djklup/SignalSenders/Project Details/IMG_0490.JPG

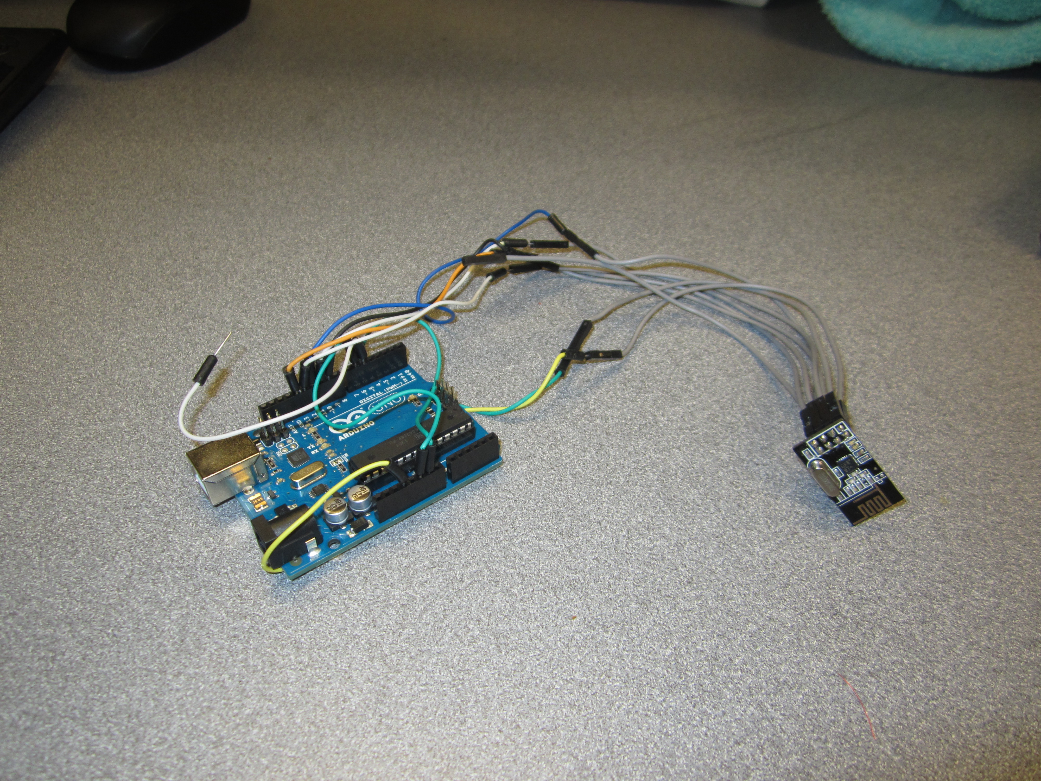
Project Details/IMG_0490.JPG
