djklup/SignalSenders/Project Details/IR Presentation 3.pptx

## Infrared alert system with radio frequency capability

T09-Signal senderS
Max Cope
Leslie Eide
Chris Klupenger

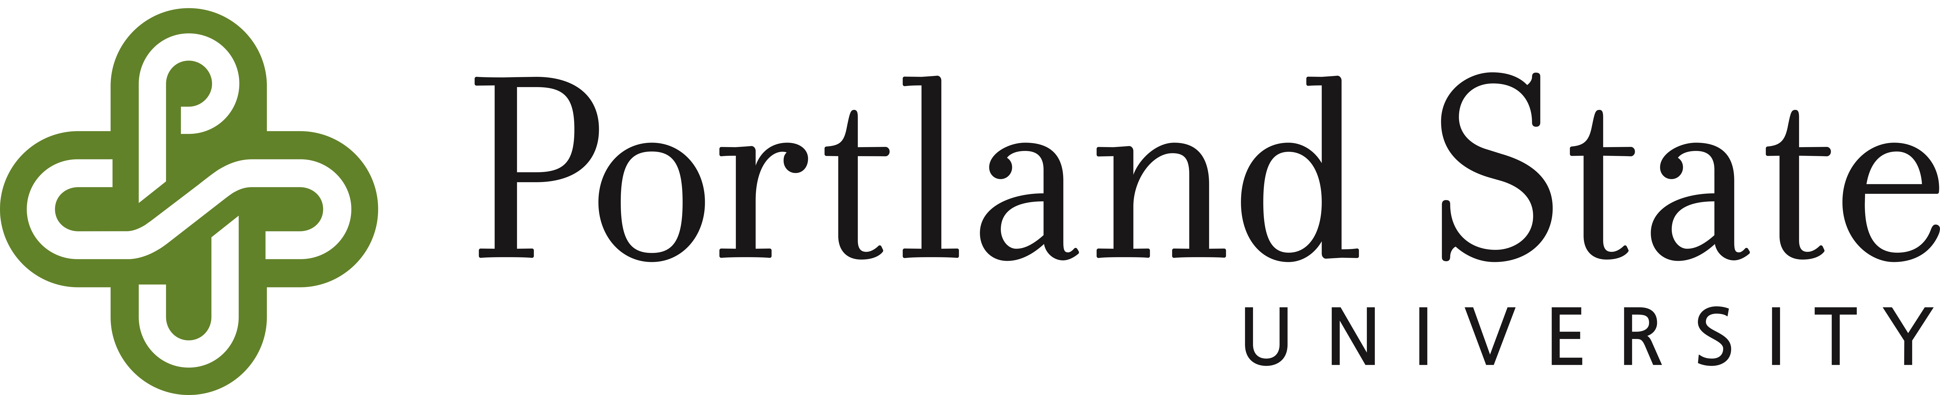
[picture p2: figure]
PSU_white_screen

SignalSenders

## Problem

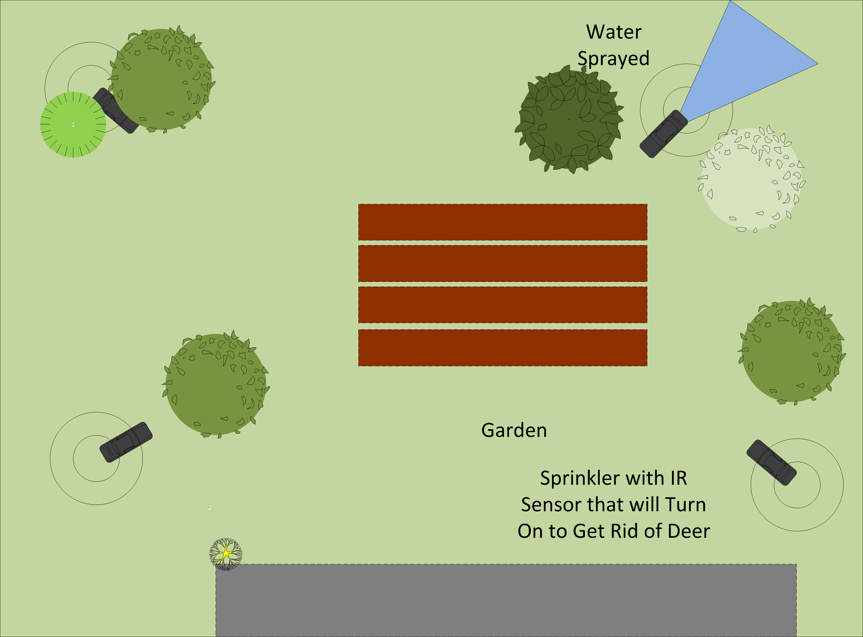
[picture p3: figure]

- Practicum Project Guidelines

Motivation

- Originated from Sprinklers Systems Designed to Keep Deer off Property
- The Systems Lacked Many Features
  - Communication Between Units
  - Timers

SignalSenders

## Objective

- Develop a Security Network with Communication Capabilities
- Utilize Communication within the 2.4GHz ISM band to lessen complexity
- Battery Operated to Eliminate Hard Wired Constrictions

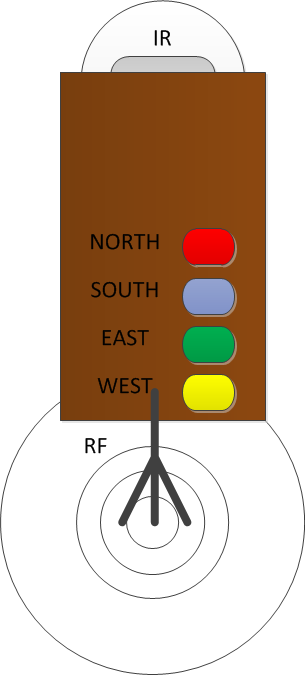
[picture p4: figure]

SignalSenders

## Alternatives

- Wired UNITS

- Inefficient at larger ranges
- Cables everywhere

- Signal Options

- WIFI
- Bluetooth
- RF Signals
- IR Signal

SignalSenders

## Requirements

- Motion Sensor

- Used to sense motion within a specified range
- Signal used to send specified signal to microcontroller for further processing

- microcontroller

- Central to the operation of this system
- Takes signal from IR and tells the RF module to send a signal that it detected motion
- Takes signal from RF module that another unit sensed motion and light up the corresponding LED associated with the unit ID

- Signal

- In standby listening for a signal from the other units to send to the microcontroller
- When prompted from the Microcontroller a signal with unit ID is transmitted to the other units

SignalSenders

## Approach

Change to something other than interrupt.

Interaction View

Activity View

Change to 1 pin

Change to 5 pin spi

SignalSenders

## Design

Identifying the Appropriate
  - Motion Detector
  - Microcontroller
  - RF Transceiver
  - LED Indicators
  - Battery Power
  - Housing

SignalSenders

## Infrared motion sensor Design

- 5v Power
- Ground
- 1 Bit Active High Data Bit
- User Definable Potentiometers
  - Sensitivity
  - Rate of (detection?)

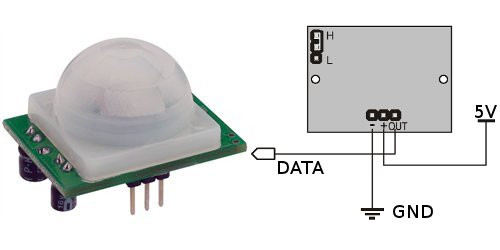
[picture p5: figure]

SignalSenders

## Radio frequency Communication

- Handles All RF Tasks
- 2.4 GHz ISM Band
  - Worldwide license-free
- Communication Pipes
  - A Unique Pipe for Each Units Communication
  - Simultaneous Unit Communication

- SPI interfacing with C
  - CE
  - CS
  - MOSI
  - MISO
  - SCK
- Configurable through Programming
- “RF24” Libraries.

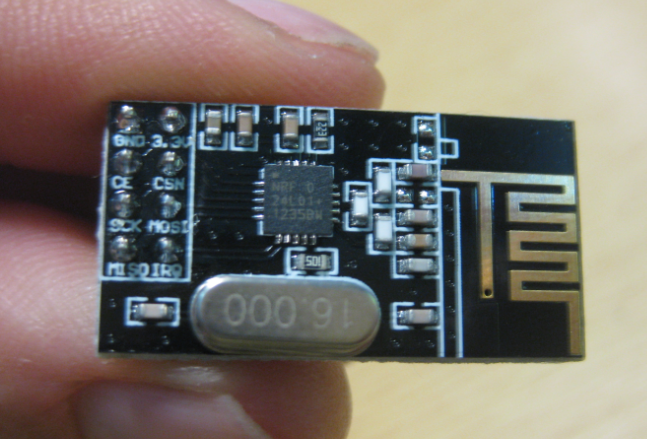
[picture p6: figure]

SignalSenders

## Microcontroller Programming

- ATMEGA 328P
- Programming
  - IR Detect
  - RF SPI
  - Four LED
  - Unit Identification

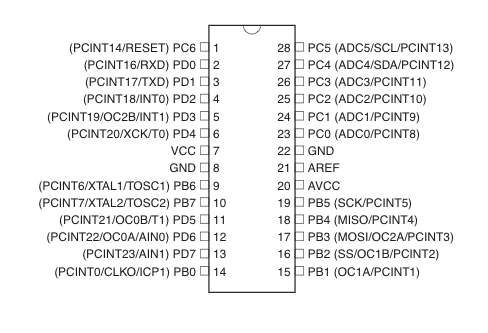
[picture p7: figure]

- Programmed Through SPI

SignalSenders

## LED Output

- Four LED Outputs
  - One LED Indicator to Represent Each Unit
  - All Power Sourced from C!
- Analog Voltage Signal
- Blink to Indicate a Trip on Respective Unit.
  - Specified Indication Time Span

SignalSenders

## Slide 12

Verification

- Subsections of circuit were built and tested on breadboard
- Changes such as digital output pins used, SPI connectivity, etc. stemmed from early verification work

## Implementation Schematic - POWER

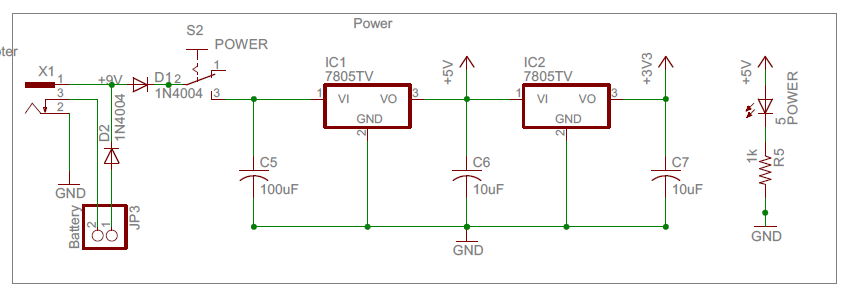
[picture p8: figure]

SignalSenders

## Implementation Schematic – Modules

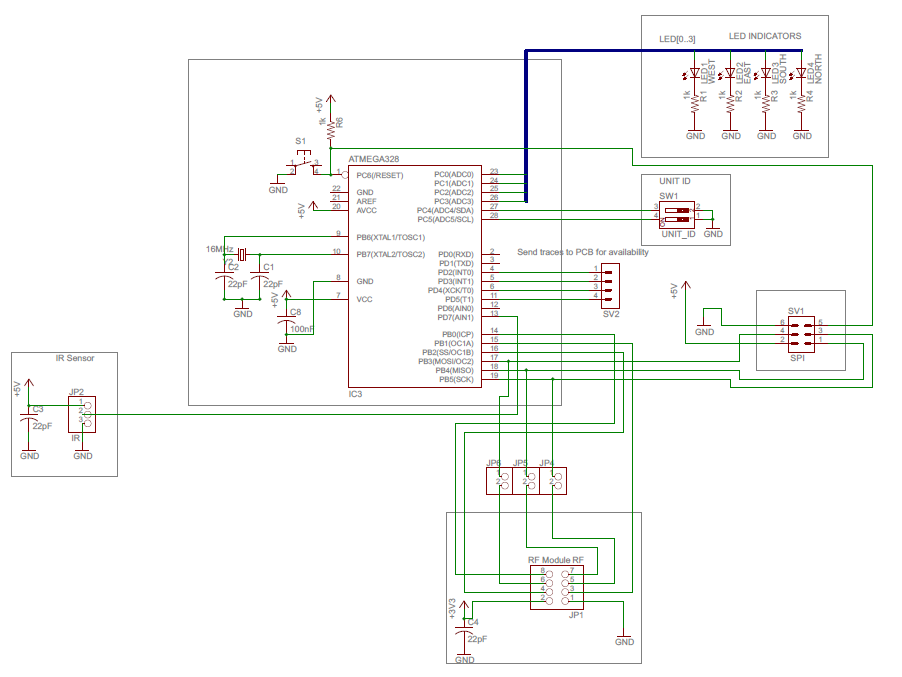
[picture p9: figure]

SignalSenders

## Implementation PCB

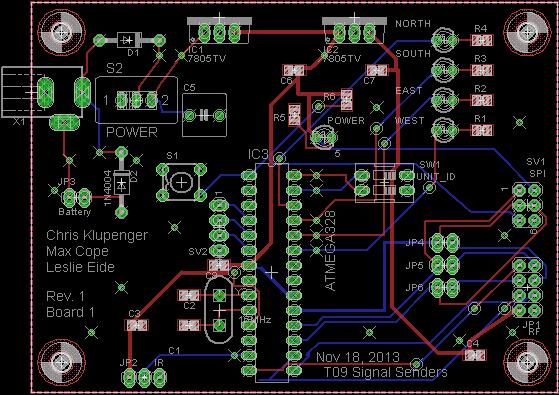
[picture p10: figure]

SignalSenders

## Intellectual property prior work

- RF Module libraries found online
- Open source Arduino coding
- Nothing proprietary created
- No schematics followed

SignalSenders

## Testing

- Strategy

- Testing power
- Continuity
- Layering complexity

- Execution

- Talk about issues/lack there of

SignalSenders

## Results

- 4 working units (video potential?)

SignalSenders

## Contributions

- Max cope

- RF signals
- RF Firmware

- Leslie Eide

- IR motion detector
- LED output panel

- Microcontroller
- Programming

- Chris Klupenger

SignalSenders

## Lessons Learned

SignalSenders
