djklup/SignalSenders/Project Details/IR Presentation 2.pptx

## Infrared alert system with radio frequency capability

T09-Signal senderS
Max Cope
Leslie Eide
Chris Klupenger

PSU_white_screen

SignalSenders

## Problem


- Practicum Project Guidlines

Motivation

- Originally got idea from sprinklers designed to keep deer out of yards.
- Interests in Radio signals
- Battery operation for range extension
- Original concepts included mechanical aspects for actuation

SignalSenders

## Objective

- Develop four working prototypes that can communicate with each other when they sense motion.
- Utilize communication within the 2.4GHz ISM band to lessen complexity
- Rely on battery power to reduce bulk and understand current dissipation vs voltage


SignalSenders

## Alternatives

- Wired

- Inefficient at larger ranges

- Wi-fi

- Bluetooth was also explored

SignalSenders

## Requirements

- Motion Sensor

- Used to sense motion within a specified range
- Signal used to send specified signal to microcontroller for further processing

- microcontroller

- Central to the operation of this system
- Takes signal from IR and tells the RF module to send a signal that it detected motion
- Takes signal from RF module that another unit sensed motion and light up the corresponding LED associated with the unit ID

- Signal

- In standby listening for a signal from the other units to send to the microcontroller
- When prompted from the Microcontroller a signal with unit ID is transmitted to the other units

SignalSenders

## Approach

SignalSenders

## Design

- Selection of motion detection
- Selection of Microcontroller
- Selection of communication
- Selection of Actuator
- Selection of battery power
- Design of schematic
- Design of PCB
- Housing

SignalSenders

## Infrared motion sensor Design

- Range
- Output of Signal


SignalSenders

## Radio frequency Communication

- 2.4 GHz ISM Band
  - Worldwide license-free
- GFSK modulation
- Communication Pipes
- SPI interfacing with uC


SignalSenders

## Microcontroller Programming

- ATMEGA 328P
- Programming
  - IR Detect
  - RF SPI
  - Four LED


SignalSenders

## LED Output

- Layout of board/housing

SignalSenders

## Schematic/PCB


## Implementation

SignalSenders

## Intellectual property prior work

- No idea about this slide waiting for Monday

SignalSenders

## Testing

- Strategy

- Execution

SignalSenders

## Results

- 4 working units (video potential?)

SignalSenders

## Contributions

- Max cope

- RF signals
- RF Firmware

- Leslie Eide

- IR motion detector
- LED output panel

- Microcontroller
- Programming

- Chris Klupenger

SignalSenders

## Lessons Learned

SignalSenders
