djklup/SignalSenders/Project Details/IR Presentation.pptx

## Infrared alert system with radio frequency capability

Signal senders
Max Cope
Leslie Eide
Chris Klupenger

PSU_white_screen

SignalSenders

## Problem

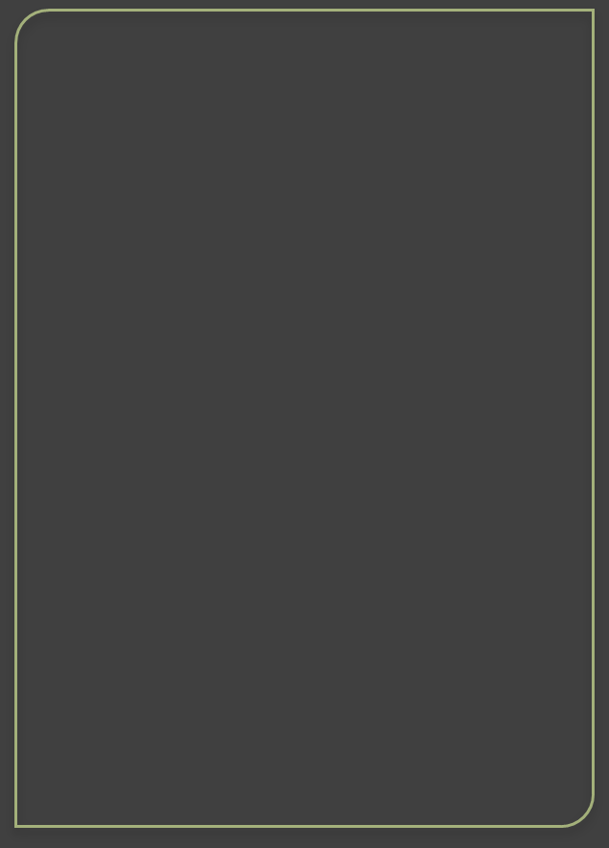
[picture p11: figure]

- Utilize our skills to build a project from the ground up

Motivation

- Interests in Radio signals
- Battery operation for range extension
- Original concepts included mechanical aspects for actuation

SignalSenders

## Objective

- Develop a working prototype with four units that can communicate to each other when they sense motion.
- Utilize wireless signals within (Hz range) adhering to FCC regulations
- Rely on battery power to reduce bulk and understand the current dissipation vs voltage

SignalSenders

## Alternatives

- Wired

- Difficult to implement in large range spans

- Wi-fi

- Bluetooth was also explored

SignalSenders

## Requirements

- Motion Sensor

- Used to sense motion within a specified range
- Signal used to send specified signal to microcontroller for further processing

- microcontroller

- Central to the operation of this system
- Takes signal from IR and tells the RF module to send a signal that it detected motion
- Takes signal from RF module that another unit sensed motion and light up the corresponding LED associated with the unit ID

- Signal

- In standby listening for a signal from the other units to send to the microcontroller
- When prompted from the Microcontroller a signal with unit ID is transmitted to the other units

SignalSenders

## Approach

SignalSenders

## Design

- Selection of motion detection
- Selection of Microcontroller
- Selection of communication
- Selection of Actuator
- Selection of battery power
- Design of schematic
- Design of PCB
- Housing

SignalSenders

## Infrared motion sensor Design

- Range
- Output of Signal

SignalSenders

## Radio frequency Communication

- Communication to send
- Communication to recieve

SignalSenders

## Microcontroller Programming

- Choice of Microcontroller
- Programming
- Interface??

SignalSenders

## LED Output

- Layout of board/housing

SignalSenders

## Schematic/PCB

## Implementation

SignalSenders

## Intellectual property prior work

- No idea about this slide waiting for Monday

SignalSenders

## Testing

- Strategy

- Execution

SignalSenders

## Results

- 4 working units (video potential?)

SignalSenders

## Contributions

- Max cope

- RF signals

- Leslie Eide

- IR motion detector
- LED output panel

- Microcontroller
- Programming

- Chris Klupenger

SignalSenders

## Lessons Learned

SignalSenders
