djklup/SignalSenders/Board/T09_Board Layout.pdf

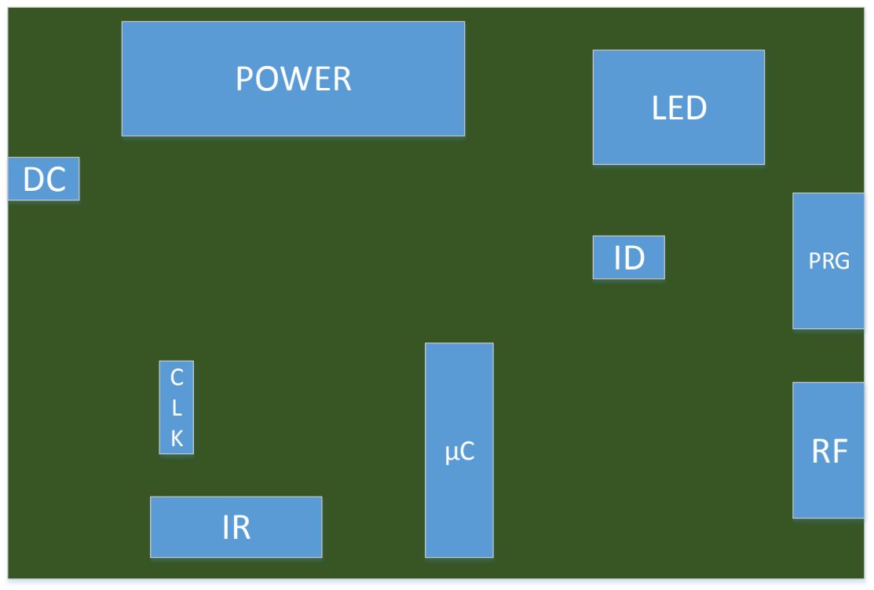
[picture p12: page 1]

POWER

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
