djklup/SignalSenders/Project Details/Gnatt Chart.pdf

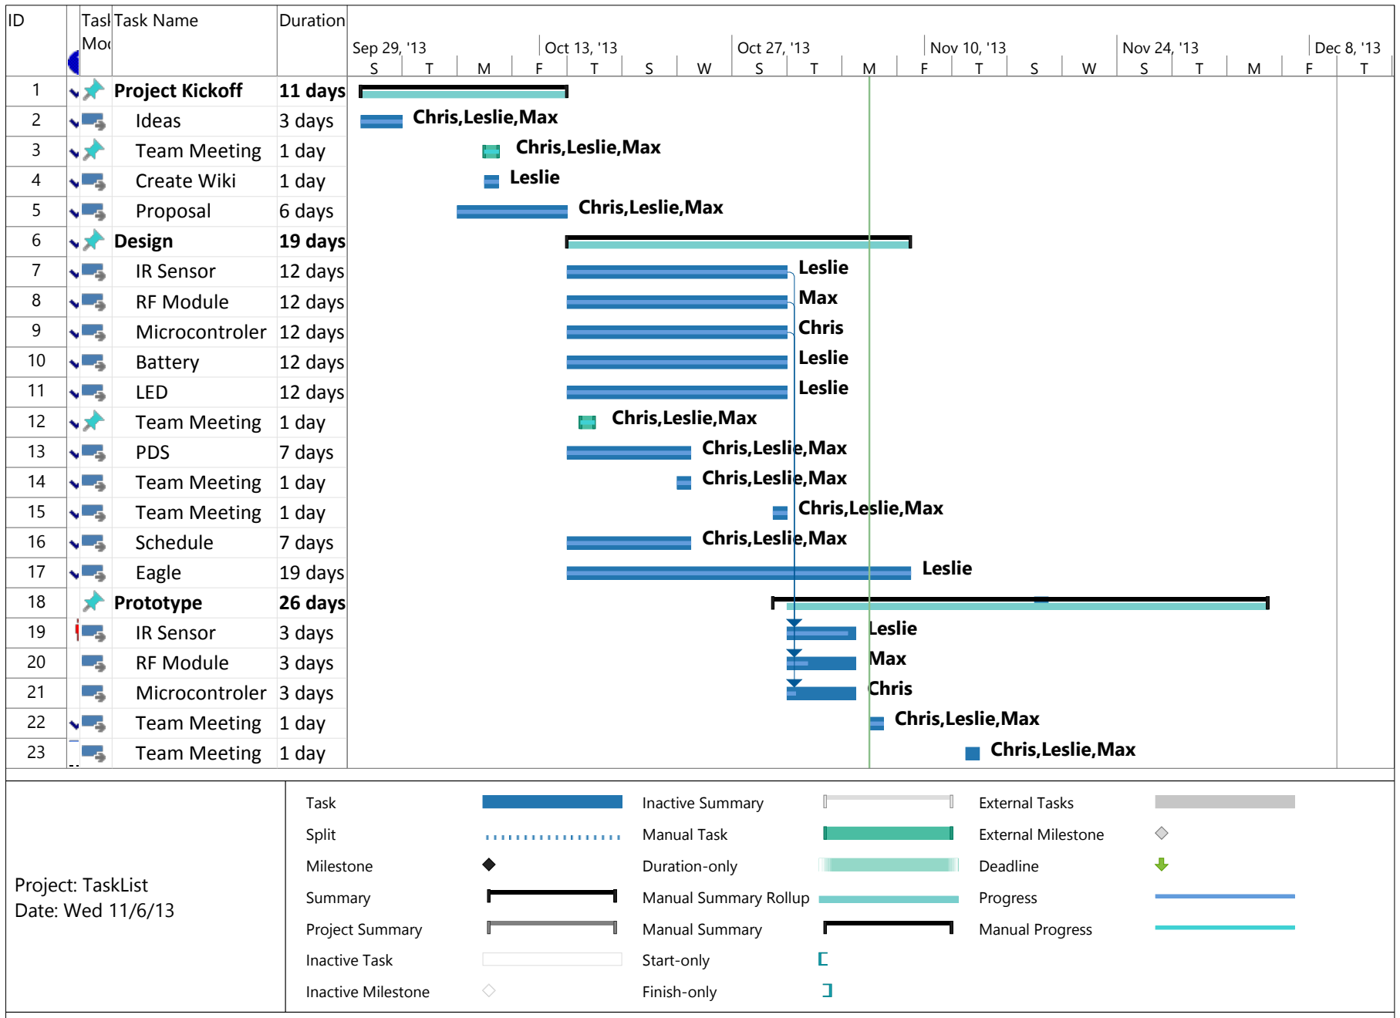
[picture p13: figure]
Task; Mode; Task Name; Duration; Project Kickoff; 11 days; Ideas; 3 days; Team Meeting; 1 day; Create Wiki; Proposal; 6 days; Design; 19 days; IR Sensor; 12 days; RF Module; Microcontroler; Battery; LED; PDS; 7 days; Schedule; Eagle; Prototype; 26 days; Chris,Leslie,Max; Leslie; Max; Chris; Sep 29, '13; Oct 13, '13; Oct 27, '13; Nov 10, '13; Nov 24, '13; Dec 8, '13; Split; Milestone; Summary; Project Summary; Inactive Task; Inactive Milestone; Inactive Summary; Manual Task; Duration-only; Manual Summary Rollup; Manual Summary; Start-only; Finish-only; External Tasks; External Milestone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

ID | Task
Mode
| Task Name | Duration
24 | System Design | 6 days
25 | Team Meeting | 1 day
26 | Order Parts | 11 days
27 | Order Board | 1 day
28 | Test Plan | 6 days
29 | GetHub | 1 day
30 | Team Meeting | 1 day
31 | Construction | 4 days
32 | Team Meeting | 1 day
33 | Construction | 1 day
34 | Housing | 1 day
35 | Testing | 4 days
36 | Presentation | 11 days
37 | Power Point | 11 days
38 | Demostration | 1 day
39 | Final Review | 1 day

Chris,Leslie,Max
Chris,Leslie,Max
Chris,Leslie,Max
Chris,Leslie,Max
Chris,Leslie,Max
Chris
Chris,Leslie,Max

Chris,Leslie,Max
Chris,Leslie,Max
Chris,Leslie,Max
Chris,Leslie,Max

Chris,Leslie,Max
Chris,Leslie,Max
Chris,Leslie,Max
S | T | M | F | T | S | W | S | T | M | F | T | S | W | S | T | M | F | T
Sep 29, '13 | Oct 13, '13 | Oct 27, '13 | Nov 10, '13 | Nov 24, '13 | Dec 8, '13

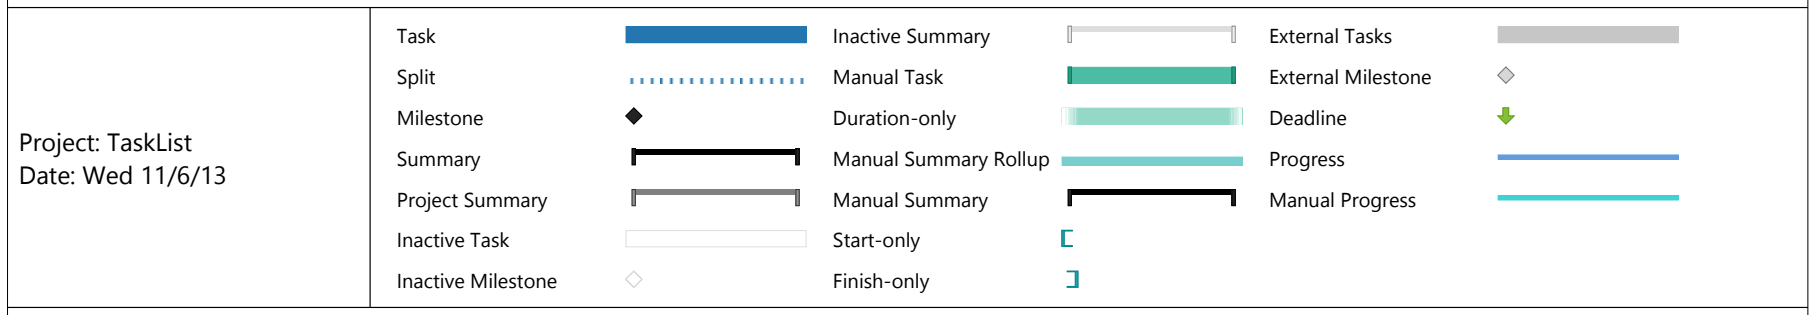
[picture p14: figure]
Task; Split; Milestone; Summary; Project Summary; Inactive Task; Inactive Milestone; Inactive Summary; Manual Task; Duration-only; Manual Summary Rollup; Manual Summary; Start-only; Finish-only; External Tasks; External Milestone; Deadline; Progress; Manual Progress; Project: TaskList Date: Wed 11/6/13
