djklup/SignalSenders/Project Details/BOM.xlsx

PART # | ITEM | PART # | DISTRIBUTOR | DIST PART # | Quantity | UNIT COST | TOTAL | SMT | PCB Verified
C1-C4 | 22pF CAPACITOR | C0805C220J5GACTU | DIGIKEY | 399-1113-1-ND | 30 | 0.048 | 1.44 | YES | YES
C5 | 100uF CAPACITOR | EEU-FR1C101B | DIGIKEY | P15330CT-ND | 10 | 0.409 | 4.09 | NO | YES
C6-C7 | 10uF CAPACITOR | C0805C106Z8VACTU | DIGIKEY | 399-8015-1-ND | 15 | 0.11 | 1.65 | YES | YES
C8 | 100nF CAPACITOR | CL21F104ZAANNNC | DIGIKEY | 1276-1286-1-ND | 10 | 0.031 | 0.31 | YES | YES
D1 | DIODE | 1N4004-T (http://www.digikey.com/product-detail/en/1N4004-T/1N4004DICT-ND/160593) | DIGIKEY | 1N4004DICT-ND | 10 | 0.12 | 1.20 | NO | YES
IC1 | VOLTAGE REG 5V | L78S05CV | DIGIKEY | 497-1468-5-ND | 10 | 0.637 | 6.37 | NO | YES
IC2 | VOLTAGE REG 3.3V | MCP1825S-3302E/AB | DIGIKEY | MCP1825S-3302E/AB-ND | 10 | 0.82 | 8.20 | NO | YES
IC3 | MICROCONTROLLER | ATMEGA328P-PU | DIGIKEY | ATMEGA328P-PU-ND | 10 | 3.16 | 31.60 | NO | YES
JP1 | PIN HEADER 2X4 FML | PPPC042LFBN-RC | DIGIKEY | S7107-ND | 10 | 0.699 | 6.99 | NO | YES
JP2-JP6 | 1x PIN HEADERS |  | HAVE |  |  |  | 0.00 | NO | YES
LED 1-5 | LEDs | LS-00016 | FRYS | 7726888 | 1 | 7.49 | 7.49 | NO | NO-SHOULD BE OK
R1-R6 | 1K RESISTOR | ERJ-P06J102V | DIGIKEY | P1.0KADCT-ND | 50 | 0.087 | 4.35 | YES | YES
S1 | PUSH BUTTON SWITCH | FSM4JH | DIGIKEY | 450-1650-ND | 10 | 0.092 | 0.92 | NO | YES
S2 | SLIDE POWER SWITCH |  | POWER |  |  |  | 0.00 | NO
SV1 | PIN HEADER 2X3 ML | 5-146254-3 | DIGIKEY | A105155-ND | 10 | 0.44 | 4.40 | NO | YES
SV2 | 1x PIN HEADERS |  | HAVE |  |  |  | 0.00 | NO | YES
SW1 | DIP SWITCH | 209-2MS | DIGIKEY | CT2092MS-ND | 10 | 0.543 | 5.43 | NO | YES
X1 | DC ADAPTER | PJ-202A | DIGIKEY | CP-202A-ND | 10 | 0.644 | 6.44 | NO | YES
Y2 | 16MHz CRYSTAL | ATS16B | DIGIKEY | CTX1085-ND | 10 | 0.3 | 3.00 | NO | YES
JMP1 | SHUNT/JUMPER | 4-881545-2 | DIGIKEY | A26853-ND | 25 | 0.257 | 6.42 | NO | YES
SKT 1 | uC IC SOCKET 28 POS | 1-390261-9 | DIGIKEY | A100210-ND | 10 | 0.411 | 4.11 | NO | YES
TOTAL |  |  |  |  |  |  | 104.42
RF 1 | RF Module 10 Pack | NRF24L01+ | EBAY |  | 1 | 17.28 |  | no | yes
IR 1 | IR SENSOR |  |  |  | 1
PCB | PCB BOARDS |  |  |  | 10
HS1 | HOUSING
