djklup/SignalSenders/(list of files, cad)

Other CAD files:
Parts/RF Module/code/51_NRF24L01+/test code/recive/recive.OBJ
Parts/RF Module/code/51_NRF24L01+/test code/send/send.OBJ
