djklup/SignalSenders/Project Details/TestingPlan.xlsx

Sheet: 5.1.1
Test Writer: Chris Klupenger
Test Case Name: |  | Power Switch and Indicator |  |  |  | Test ID #: | 5.1.1
Description: |  | Checks to make sure that power is initially being supplied to the unit. |  |  |  | Type: | White Box
Tester Information
Name of Tester: |  |  |  |  |  | Date
Hardware Ver: |  |  |  |  |  | Time
Setup: |  | Board Should be completely assembled with Power Supply connected
Step | Action | Expected Results | Pass | Fail | N/A | Comments
1 | Connect Power Supply and verify voltage at power supply | A measured Voltage of 8.9-9.1V
2 | Flip Switch on Power section of board | Verify that Power LED illumination lights up/turns off with flipping the switch
Overall test result:

Sheet: 5.1.2
Test Writer: Chris Klupenger
Test Case Name: |  | Power Supply Voltage |  |  |  | Test ID #: | 5.1.2
Description: |  | Checks to make sure that Power is being supplied to the board at the correct voltages. All measured voltages must be +- 5% of desired voltage to pass test. A multimeter will be used to measure voltage. |  |  |  | Type: | White Box
Tester Information
Name of Tester: |  |  |  |  |  | Date
Hardware Ver: |  |  |  |  |  | Time
Setup: |  | Power section on PCB should be set up with power supply attached and switch on
Step | Action | Expected Results | Pass | Fail | N/A | Comments
1 | Measure voltage out of +5V regulator | A measured voltage of 4.75-5.25V
2 | Measure voltage out of +3.3V regulator | A measured voltage of 3.14-3.47V
3 | Measure voltage on microcontroller | A measured voltage of 4.75-5.25V
Overall test result:

Sheet: 5.2.1
Test Writer: Leslie Eide
Test Case Name: |  | Power to IR Unit |  |  |  | Test ID #: | 5.2.1
Description: |  | The purpose of this test is to make sure that the IR Module is getting +5V. |  |  |  | Type: | White Box
Tester Information
Name of Tester: |  |  |  |  |  | Date
Hardware Ver: |  |  |  |  |  | Time
Setup: |  | Board is fully powered on and IR unit is installed on the unit
Step | Action | Expected Results | Pass | Fail | N/A | Comments
1 | Before connecting unit, verify voltage at connection | A measured Voltage of 4.9-5.1V
2 | Connect IR Unit | Connect multimeter to make sure that the unit is getting power
Overall test result:

Sheet: 5.2.2
Test Writer: Leslie Eide
Test Case Name: |  | Output Power and Duration |  |  |  | Test ID #: | 5.2.2
Description: |  | The purpose of this test is to record the output voltage and the duration of the signal. |  |  |  | Type: | White Box
Tester Information
Name of Tester: |  |  |  |  |  | Date
Hardware Ver: |  |  |  |  |  | Time
Setup: |  | Board is fully powered on and IR unit is installed on the unit
Step | Action | Expected Results | Pass | Fail | N/A | Comments
1 | Trip IR sensor | Output Voltage of 3.2-3.4 V
2 | Output Signal | Time Duration of signal for 10 seconds
Overall test result:

Sheet: 5.3.1
Test Writer:Max Cope
Test Case Name: |  | Power to RF Unit |  |  |  | Test ID #: | 5.3.1
Description: |  | The purpose of this test is to make sure that the RF Module is getting +3.3V +- 10%. |  |  |  | Type: | White Box
Tester Information
Name of Tester: |  |  |  |  |  | Date
Hardware Ver: |  |  |  |  |  | Time
Setup: |  | Board is fully powered on and RF unit is installed on the unit
Step | Action | Expected Results | Pass | Fail | N/A | Comments
1 | Before connecting unit, verify voltage at connection | A measured Voltage of 3-3.6V
2 | Connect RF Unit | Connect multimeter to make sure that the unit is getting power
Overall test result:

Sheet: 5.3.2
Test Writer:Max Cope
Test Case Name: |  | Transceiver Capability |  |  |  | Test ID #: | 5.3.2
Description: |  | Test module’s ability to both send and receive messages with no interference. |  |  |  | Type: | White Box
Tester Information
Name of Tester: |  |  |  |  |  | Date
Hardware Ver: |  |  |  |  |  | Time
Setup: |  | Two Arduino Unos are set up with RF test software loaded
Step | Action | Expected Results | Pass | Fail | N/A | Comments
1 | Connect module one to Arduino two | Module receives power and is on.
2 | Start Arduino tester software on Arduino one | Serial Port "Ready" message displayed on screen.
3 | Connect module two to Arduino two | Module receives power and is on.
4 | Start Arduino tester software on Arduino two | Serial port "Ready" message displayed on screen.
5 | Start test | Serial port should show a read out of the units "pinging" eachother and displaying timing results.
Overall test result:

Sheet: 5.4.1
Test Writer: Chris Klupenger
Test Case Name: |  | Microcontroller was Programmed |  |  |  | Test ID #: | 5.4.1
Description: |  | Test to verify that the microcontroller has the correct firmware running on it. |  |  |  | Type: | White Box
Tester Information
Name of Tester: |  |  |  |  |  | Date
Hardware Ver: |  |  |  |  |  | Time
Setup: |  | Unit should be fully assembled and powered on
Step | Action | Expected Results | Pass | Fail | N/A | Comments
1 | Trip the IR sensor | Verify that this units LED light is illuminated when the IR sensor is tripped
Overall test result:

Sheet: 5.5.1
Test Writer: Chris Klupenger
Test Case Name: |  | Testing Two Units |  |  |  | Test ID #: | 5.5.1
Description: |  | Verify that two units are communicating in an appropriate manner under various conditions. |  |  |  | Type: | Black Box
Tester Information
Name of Tester: |  |  |  |  |  | Date
Hardware Ver: |  |  |  |  |  | Time
Setup: |  | Two powered-on units should be placed on on opposite ends of a room from each other - maximum 100ft away
Step | Action | Expected Results | Pass | Fail | N/A | Comments
1 | North Unit Sends a Signal | South Unit Receives North Unit Signal
2 | South Unit Sends a Signal | North Unit Receives South Unit Signal
3 | Both Units Sends Signals | Both associated LED's Light up
4 | Wait 60 seconds | All LED's off
5 | Neither Sends a signal | No LED's Light up
6 | Wait 60 seconds | All LED's off
Overall test result:

Sheet: 5.5.2
Test Writer: Chris Klupenger
Test Case Name: |  | Testing Three Units |  |  |  | Test ID #: | 5.5.2
Description: |  | Verify that three units are communicating in an appropriate manner under various conditions. |  |  |  | Type: | Black Box
Tester Information
Name of Tester: |  |  |  |  |  | Date
Hardware Ver: |  |  |  |  |  | Time
Setup: |  | Three powered-on units should be placed on on opposite ends of a room from each other - maximum 100ft away from the farthest module. Each unit should be given a unique ID via the DIP switch.
Step | Action | Expected Results | Pass | Fail | N/A | Comments
1 | North Unit Sends a Signal | South and West Unit Recieves North Unit Signal
2 | South Unit Sends a Signal | North and West Unit Recieves South Unit Signal
3 | West Unit Sends a Signal | North and South Unit Recieves South Unit Signal
4 | All Units Sends Signals | All associated LED's Light up
5 | Wait 60 seconds | All LED's off
6 | Neither Sends a signal | No LED's Light up
7 | Wait 60 seconds | All LED's off
Overall test result:

Sheet: 5.5.3
Test Writer: Chris Klupenger
Test Case Name: |  | Testing Four Units |  |  |  | Test ID #: | 5.5.3
Description: |  | Verify that four units are communicating in an appropriate manner under various conditions. |  |  |  | Type: | Black Box
Tester Information
Name of Tester: |  |  |  |  |  | Date
Hardware Ver: |  |  |  |  |  | Time
Setup: |  | Three powered-on units should be placed on opposite ends of a room from each other - maximum 100ft away from the farthest module. Each unit should be given a unique ID via the DIP switch.
Step | Action | Expected Results | Pass | Fail | N/A | Comments
1 | North Unit Sends a Signal | South and West and East Unit Receives North Unit Signal
2 | South Unit Sends a Signal | North and West and East Unit Receives South Unit Signal
3 | West Unit Sends a Signal | North and South and East Unit Receives South Unit Signal
4 | East Unit Sends a Signal | North and South and West Unit Receives South Unit Signal
4 | All Units Sends Signals | All associated LED's Light up
5 | Wait 60 seconds | All LED's off
6 | Neither Sends a signal | No LED's Light up
7 | Wait 60 seconds | All LED's off
Overall test result:
