djklup/SignalSenders/Schematics/T09_Signal Senders.pdf

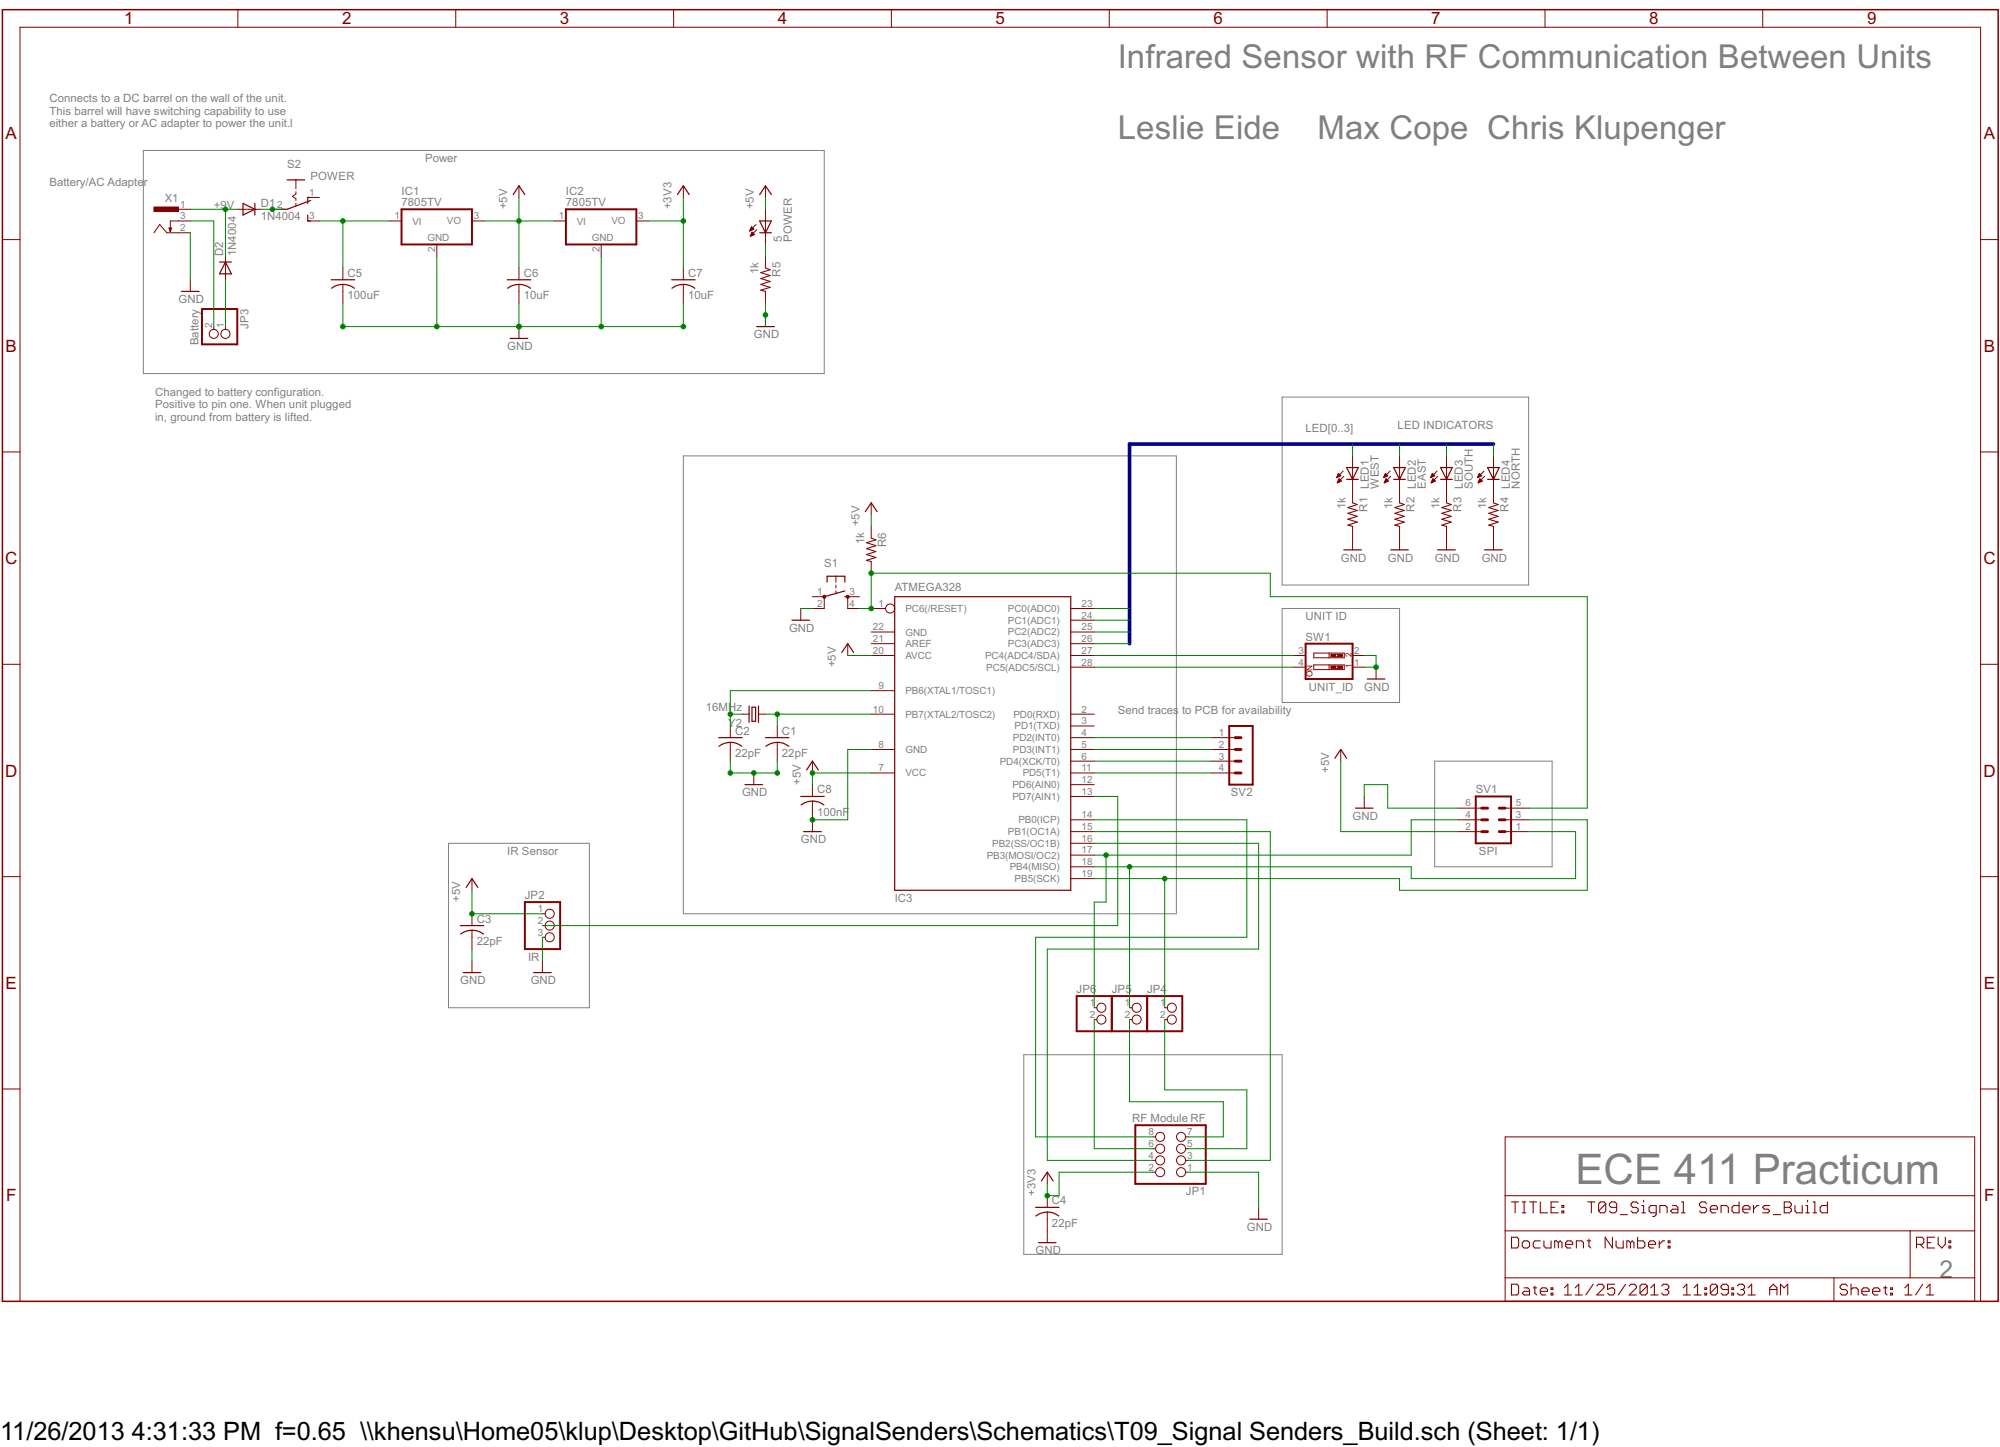
[picture p21: page 1]

Infrared Sensor with RF Communication Between Units

Connects to a DC barrel on the wall of the unit. This barrel will have switching capability to use

either a battery or AC adapter to power the unit.l

Changed to battery configuration. Positive to pin one. When unit plugged

in, ground from battery is lifted.

11/26/2013 4:31:33 PM f=0.65 \\khensu\Home05\klup\Desktop\GitHub\SignalSenders\Schematics\T09_Signal Senders_Build.sch (Sheet: 1/1)
