djklup/SignalSenders/Schematics/Signal Senders.pdf

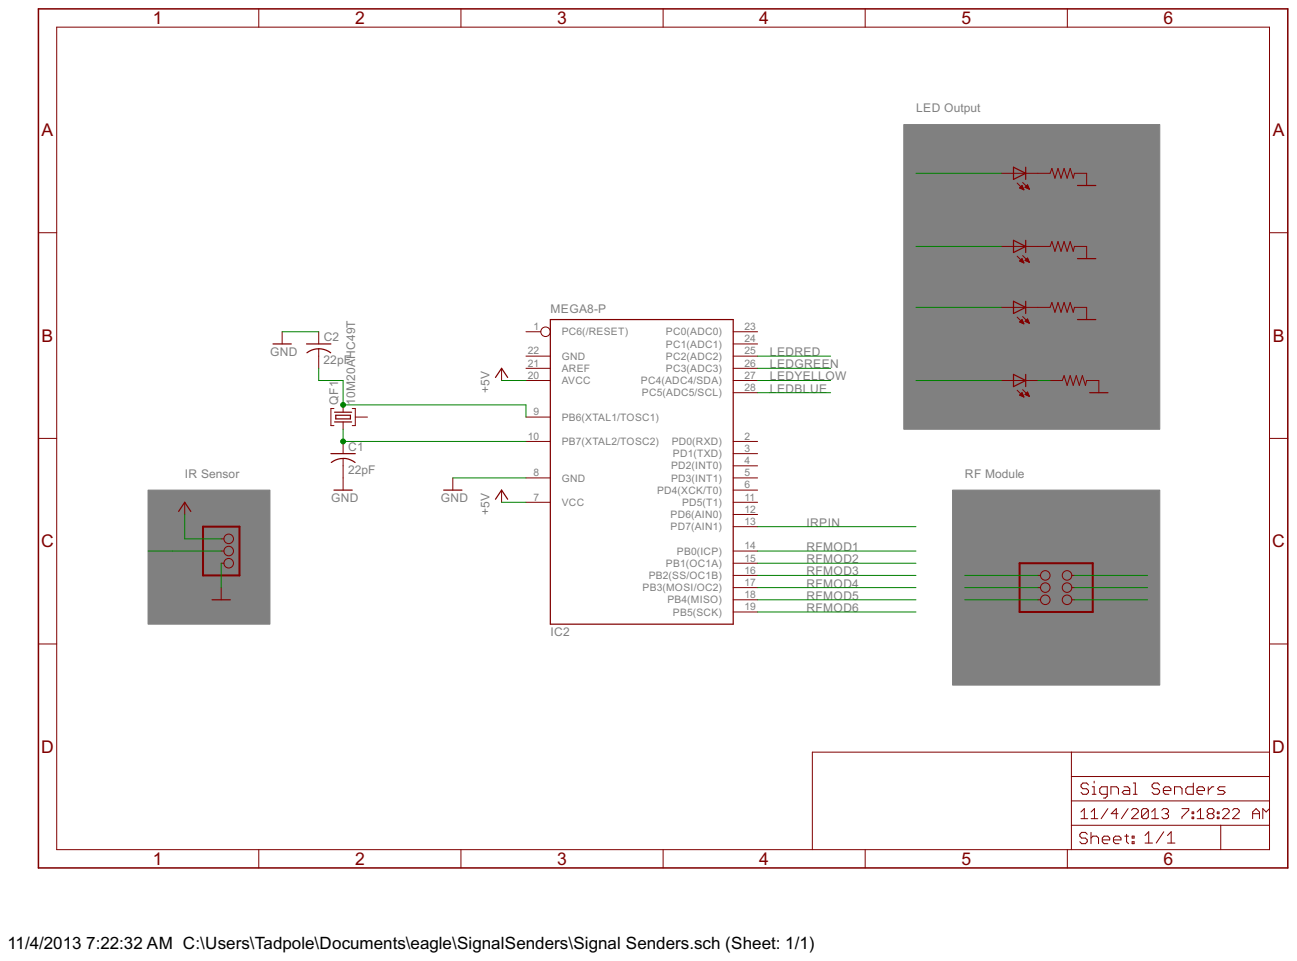
[picture p22: page 1]

11/4/2013 7:22:32 AM C:\Users\Tadpole\Documents\eagle\SignalSenders\Signal Senders.sch (Sheet: 1/1)
