djklup/SignalSenders/(list of files, drawings)

Other design files:
Parts/RF Module/datasheet/NRF24L01 reference PCB.PCB
