djklup/SignalSenders/Schematics/T09_Signal Senders_Build.brd

## EAGLE design Schematics/T09_Signal Senders_Build.brd (2013-11-19)

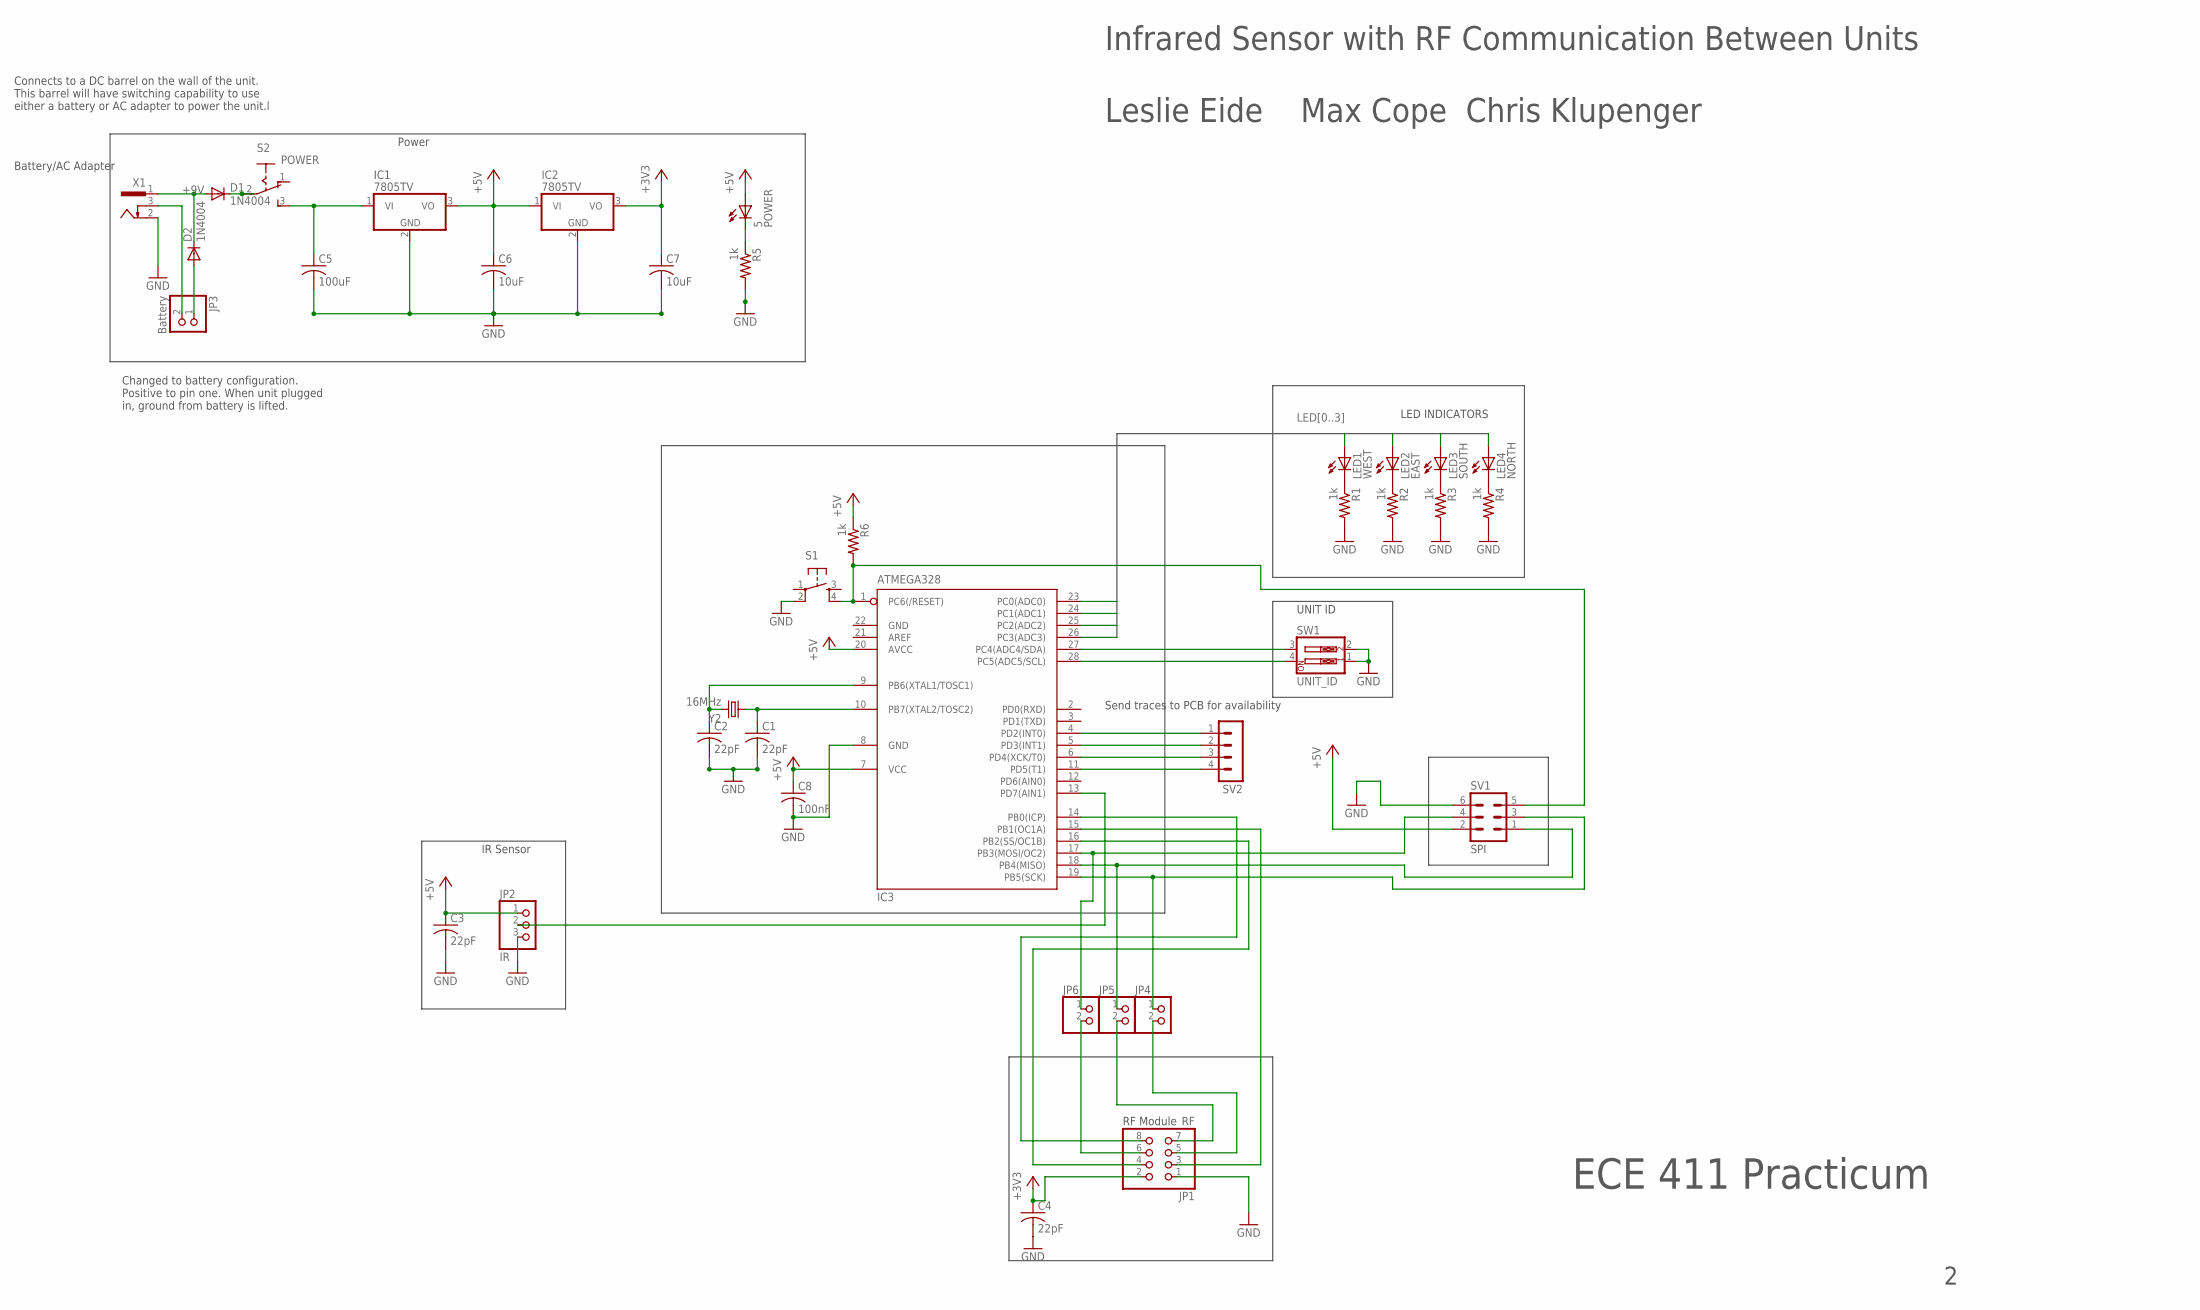
[picture p23: schematic T09_Signal Senders_Build.sch]

Parts:
5: POWER; LED3MM
C1, C2, C3, C4: 22pF; C0805
C5: 100uF; C050-075X075
C6, C7: 10uF; C0805
C8: 100nF; C0805
D1, D2: 1N4004; DO41-10
IC1, IC2: 7805TV; TO220V
IC3: ATMEGA328; DIL28-3
JP1: RF; 2X04
JP2: IR; 1X03
JP3: Battery; 1X02
JP4, JP5, JP6: 1X02
LED1: WEST; LED3MM
LED2: EAST; LED3MM
LED3: SOUTH; LED3MM
LED4: NORTH; LED3MM
R1, R2, R3, R4, R5, R6: 1k; M0805
S1: TACTILE-PTH
S2: POWER; M251
SV1: SPI; MA03-2
SV2: MA04-1
SW1: UNIT_ID; EDG-02
X1: 733980-62
Y2: 16MHz; HC49US

Connections:
+3V3: C4.1, C7.1, IC2.3 (VO), JP1.2
+5V: 5.A, C3.1, C6.1, C8.1, IC1.3 (VO), IC2.1 (VI), IC3.7 (VCC), IC3.20 (AVCC), JP2.1, R6.1, SV1.2
+9V: D1.A, D2.C, X1.1
GND: C1.2, C2.2, C3.2, C4.2, C5.2, C6.2, C7.2, C8.2, IC1.2 (GND), IC2.2 (GND), IC3.8 (GND), IC3.22 (GND), JP1.1, JP2.3, R1.2, R2.2, R3.2, R4.2, R5.2, S1.2, SV1.6, SW1.1, SW1.2, X1.2
LED0: IC3.23 (PC0(ADC0)), LED1.A
LED1: IC3.24 (PC1(ADC1)), LED2.A
LED2: IC3.25 (PC2(ADC2)), LED3.A
LED3: IC3.26 (PC3(ADC3)), LED4.A
unnamed: IC3.1 (PC6(/RESET)), R6.2, S1.4, SV1.5
unnamed: C1.1, IC3.10 (PB7(XTAL2/TOSC2)), Y2.1
unnamed: C2.1, IC3.9 (PB6(XTAL1/TOSC1)), Y2.2
unnamed: IC3.13 (PD7(AIN1)), JP2.2
unnamed: LED1.K (C), R1.1
unnamed: LED2.K (C), R2.1
unnamed: LED3.K (C), R3.1
unnamed: LED4.K (C), R4.1
unnamed: IC3.27 (PC4(ADC4/SDA)), SW1.3
unnamed: IC3.28 (PC5(ADC5/SCL)), SW1.4
unnamed: IC3.4 (PD2(INT0)), SV2.1
unnamed: IC3.5 (PD3(INT1)), SV2.2
unnamed: D2.A, JP3.1
unnamed: JP3.2, X1.3
unnamed: IC3.6 (PD4(XCK/T0)), SV2.3
unnamed: IC3.11 (PD5(T1)), SV2.4
unnamed: 5.K (C), R5.1
unnamed: C5.1, IC1.1 (VI), S2.3 (S)
unnamed: D1.C, S2.2
unnamed: IC3.18 (PB4(MISO)), JP5.1, SV1.1
unnamed: IC3.17 (PB3(MOSI/OC2)), JP6.1, SV1.4
unnamed: IC3.19 (PB5(SCK)), JP4.1, SV1.3
unnamed: IC3.16 (PB2(SS/OC1B)), JP1.4
unnamed: IC3.14 (PB0(ICP)), JP1.8
unnamed: IC3.15 (PB1(OC1A)), JP1.3
unnamed: JP1.6, JP6.2
unnamed: JP1.7, JP5.2
unnamed: JP1.5, JP4.2

Notes on the sheet:
LED INDICATORS
RF Module
IR Sensor
UNIT ID
Power
Infrared Sensor with RF Communication Between Units Leslie Eide Max Cope Chris Klupenger
Battery/AC Adapter
ECE 411 Practicum
Send traces to PCB for availability
Connects to a DC barrel on the wall of the unit. This barrel will have switching capability to use either a battery or AC adapter to power the unit.l
Changed to battery configuration. Positive to pin one. When unit plugged in, ground from battery is lifted.

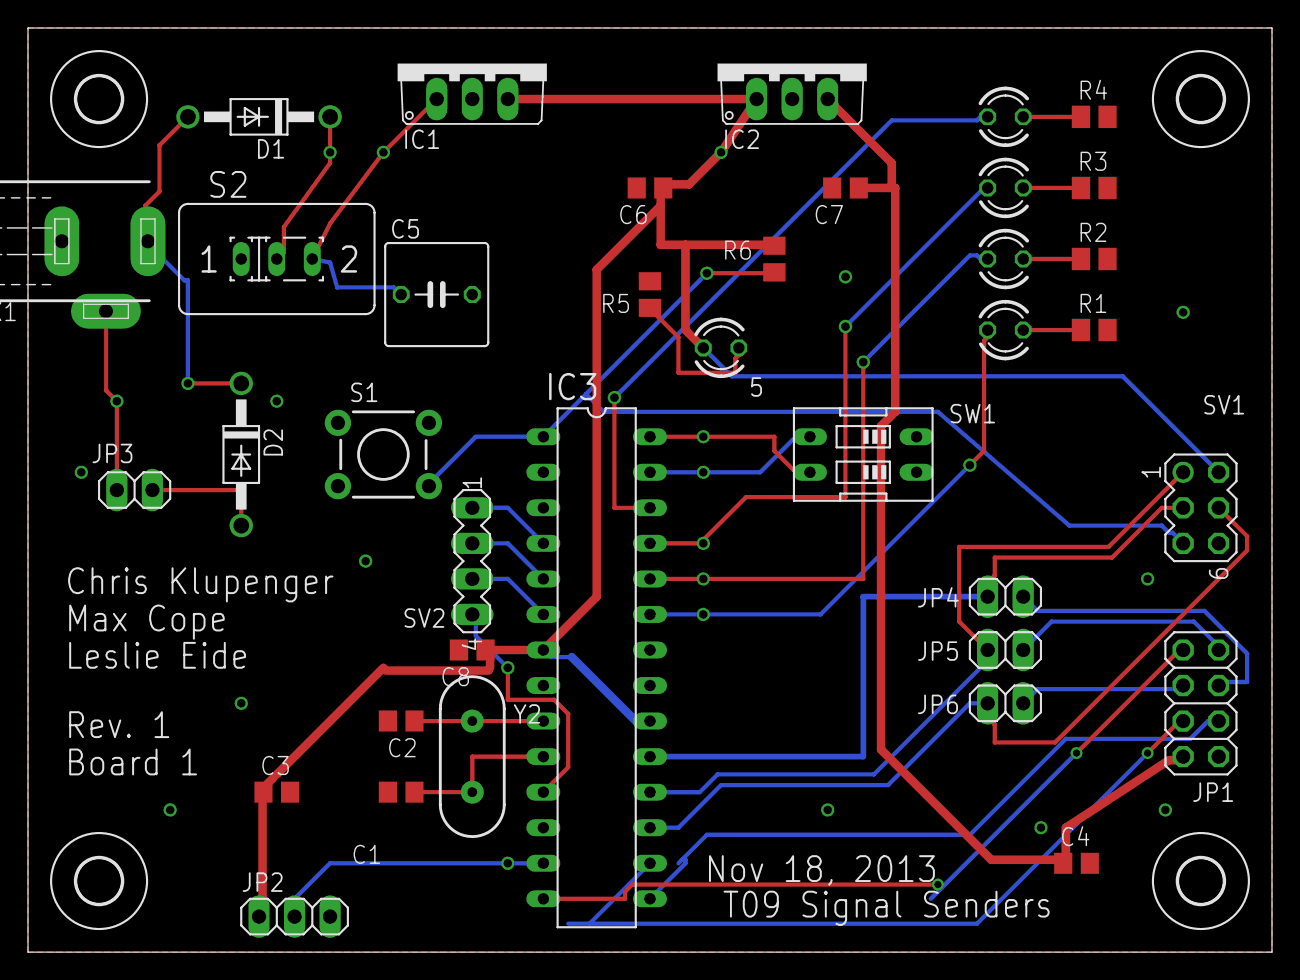
[picture p24: board Schematics/T09_Signal Senders_Build.brd from above]

Board: 2 copper layers, 88.9 x 66.0 mm, 41 parts (0 on the bottom side), 36 nets.

Other parts of the board:
U$1, U$2, U$3, U$4: 3,2
