djklup/SignalSenders/Board/T09_Signal Senders_Build.brd

## EAGLE design Board/T09_Signal Senders_Build.brd (2013-11-11)

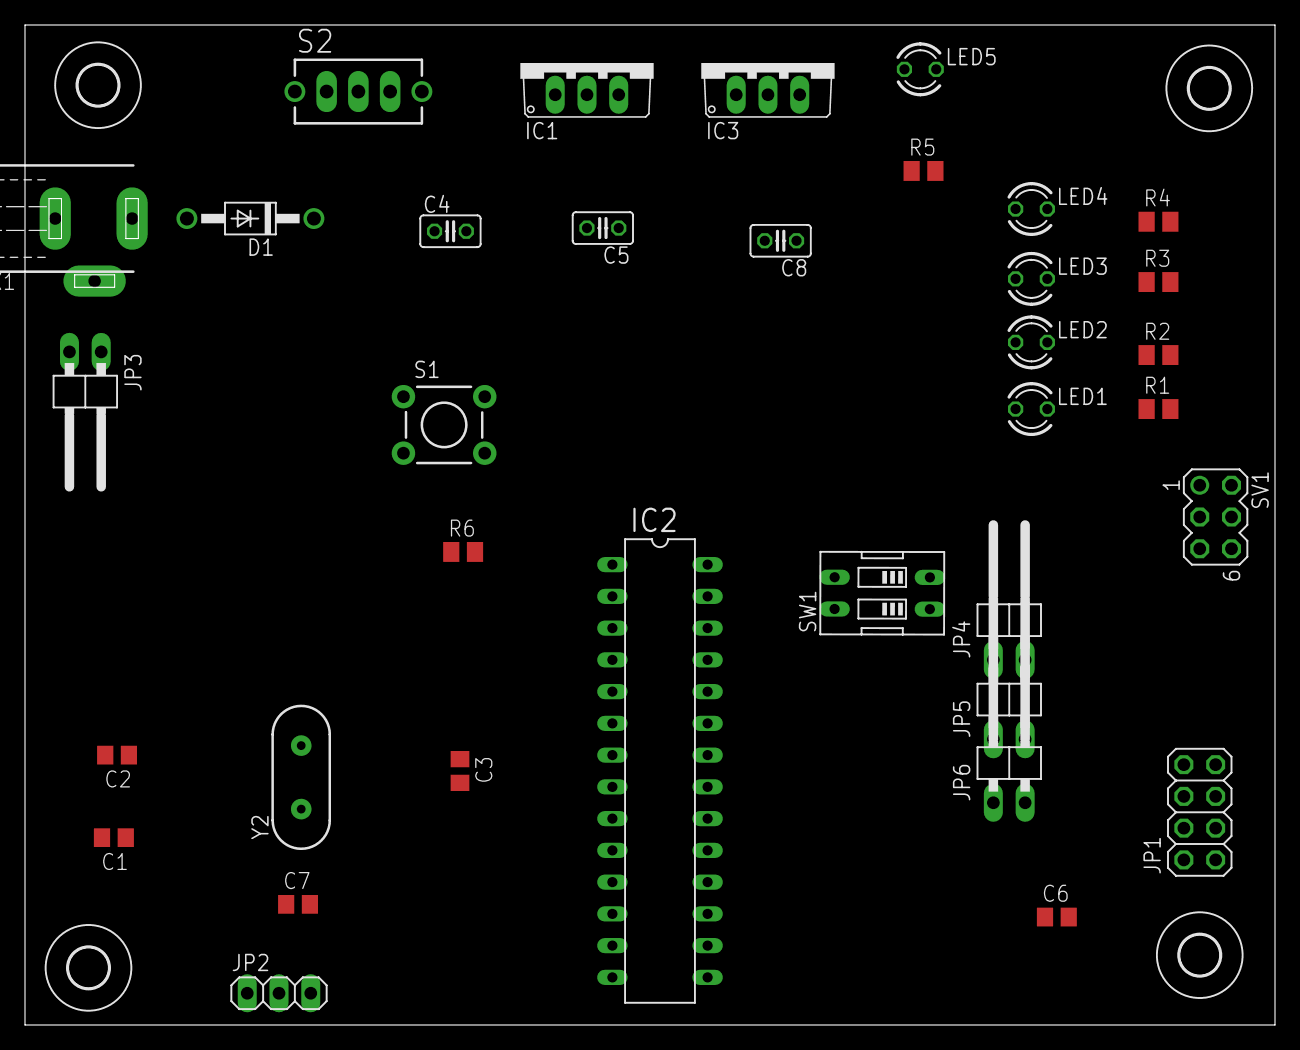
[picture p25: board Board/T09_Signal Senders_Build.brd from above]

Board: 2 copper layers, 100.0 x 80.0 mm, 39 parts (0 on the bottom side), 28 nets, no tracks yet.

Parts:
C1, C2, C6, C7: 22pF; C0805
C3: 100nF; C0805
C4: 100u; C025-025X050
C5, C8: 10u; C025-025X050
D1: 1N4004; DO41-10
IC1, IC3: 7805TV; TO220V
IC2: ATMEGA328; DIL28-3
JP1: 2X03
JP2: 1X03
JP3, JP4, JP5, JP6: 1X02/90
LED1, LED5: RED; LED3MM
LED2: GREEN; LED3MM
LED3: YELLOW; LED3MM
LED4: BLUE; LED3MM
R1, R2, R3, R4, R5, R6: 1k; M0805
S1: TACTILE-PTH
S2: TL32YO; TL3XYO
SV1: MA03-2
SW1: EDG-02
U$1, U$2, U$3, U$4: 3,2
X1: 733980-62
Y2: 16MHz; HC49US

Connections:
+3V3: C6.1, C8.1, IC3.3, JP1.2
+5V: C3.1, C5.1, C7.1, IC1.3, IC2.7, IC2.20, IC3.1, JP2.1, LED5.A, R6.1, SV1.2
+9V: D1.A, X1.1
GND: C1.2, C2.2, C3.2, C4.2, C5.2, C6.2, C7.2, C8.2, IC1.2, IC2.8, IC2.22, IC3.2, JP1.1, JP2.3, JP3.2, R1.2, R2.2, R3.2, R4.2, R5.2, S1.2, SV1.6, SW1.1, SW1.2, X1.2
LED0: IC2.23, LED1.A
LED1: IC2.24, LED2.A
LED2: IC2.25, LED3.A
LED3: IC2.26, LED4.A
unnamed: IC2.1, R6.2, S1.4, SV1.5
unnamed: C1.1, IC2.10, Y2.1
unnamed: C2.1, IC2.9, Y2.2
unnamed: IC2.13, JP2.2
unnamed: LED1.K, R1.1
unnamed: LED2.K, R2.1
unnamed: LED3.K, R3.1
unnamed: LED4.K, R4.1
unnamed: IC2.27, SW1.3
unnamed: IC2.28, SW1.4
unnamed: JP3.1, X1.3
unnamed: LED5.K, R5.1
unnamed: C4.1, IC1.1, S2.3
unnamed: D1.C, S2.2
RF_SPI0: IC2.14, IC2.16, JP1.3, JP1.4
RF_SPI1: IC2.15, JP1.8
RF_SPI2: JP1.5, JP4.2
RF_SPI3: IC2.17, JP1.6, JP6.1, JP6.2, SV1.4
RF_SPI4: IC2.18, JP1.7, JP5.1, JP5.2, SV1.1
RF_SPI5: IC2.19, JP4.1, SV1.3
