djklup/SignalSenders/(commit log)

2013-10-22 add microprocessor flowchart
    [Microprocessor flowchart.xlsx]
2013-11-04 First Eagle draft
    [Signal Senders.sch]
2013-11-04 add reset switch, add power input capacitor
    [Signal Senders.sch]
2013-11-04 untied the lines from chip to LEDs
    [Signal Senders.sch]
2013-11-05 EAGLE - upated RF module to 2x4
    [Signal Senders.sch]
2013-11-05 EAGLE - add headers for Tx and Rx
    Headers to be able to easily program the chip
    [Signal Senders.sch]
2013-11-05 Eagle Schematic - Max's changes to draft to turn in
    first draft being turned in to Andrew of Eagle schematic
2013-11-06 Updated Schematic
    Changed Border. Added wires to open uC I/O.
    [T09_Signal Senders_Build.sch]
2013-11-06 Cleaned repo.
    Reorganized files.
    [Microprocessor flowchart.xlsx, NRF24L01 reference PCB.PCB, NRF24L01.Sch, Signal Senders.sch, T09_Signal Senders_Build.sch, recive.OBJ, send.OBJ]
2013-11-06 Created Spreadsheet
    [Action Items.xlsx]
2013-11-06 Created BOM
    [BOM.xlsx]
2013-11-06 Updated Status. Added layout to action items.
    [Action Items.xlsx]
2013-11-07 Added 3.3V Rail. Can use panel mounted DC barrel.
    [T09_Signal Senders_Build.sch]
2013-11-07 Changed Part.
    [BOM.xlsx]
2013-11-09 Modified SPI section. Added DC barrel.
    [T09_Signal Senders_Build.sch]
2013-11-09 Added part verification needed for schematic.
    [Action Items.xlsx]
2013-11-09 add 6 pin header for programming
    [T09_Signal Senders_Build.sch]
2013-11-09 Fixed many ERC errors
    [T09_Signal Senders_Build.sch]
2013-11-11 first draft PCB layout
    first placements of components on PCB layout - no routing of traces has
    been done
    [T09_Signal Senders_Build.brd]
2013-11-12 Created PCB Diagram
2013-11-12 Moved to New Folder
    [T09_Signal Senders_Build.brd]
2013-11-12 Moved Board Layout to Separate Folder
    [T09_Signal Senders_Build.brd]
2013-11-12 Still Building
    [BOM.xlsx]
2013-11-12 Rearranged Battery Configuration. Still an Issue with RF SPI Nets
2013-11-13 new board layout
    smaller size, updated components, etc.
2013-11-13 new board layout
    updated stuff
    [T09_Signal Senders_Build.brd, T09_Signal Senders_Build.sch]
2013-11-13 Routed all the signals on the PCB
    [T09_Signal Senders_Build.sch]
2013-11-14 PCB - added vias, added headers to uC unused pins
    [T09_Signal Senders_Build.brd, T09_Signal Senders_Build.sch]
2013-11-16 Fixed Nets. Fixed Silkscreen Layer
    [T09_Signal Senders_Build.brd, T09_Signal Senders_Build.sch]
2013-11-16 Added Components
    [BOM.xlsx]
2013-11-17 RF nets still had errors. Still need to be routed.
    [T09_Signal Senders_Build.brd, T09_Signal Senders_Build.sch]
2013-11-17 Finished all but power switch.
    Need to find a footprint that will match what we can buy.
    [BOM.xlsx]
2013-11-17 Minor changes to traces.
    [T09_Signal Senders_Build.brd, T09_Signal Senders_Build.sch]
2013-11-18 Routed traces to PCB
2013-11-18 routed traces to PCB
    last commit didn't seem to work
    [T09_Signal Senders_Build.brd, T09_Signal Senders_Build.sch]
2013-11-18 Updated Board
    [T09_Signal Senders_Build.brd]
2013-11-18 Andrew's fixes from office hours
    [T09_Signal Senders_Build.brd, T09_Signal Senders_Build.sch]
2013-11-19 Fixes as per Andrews recommendations
    vcc lines larger, gnd vias, move crystal and bypass caps, add diode to
    battery, version, names
    [T09_Signal Senders_Build.brd, T09_Signal Senders_Build.sch]
2013-11-19 Changed RF_SPI Pinout
    [T09_Signal Senders_Build.brd, T09_Signal Senders_Build.sch]
2013-11-19 Routed 3 last pins to SPI RF
    [T09_Signal Senders_Build.brd]
2013-11-20 Added details for modules, pcb, and housing.
    [BOM.xlsx]
2013-11-21 Initial Testing Plan and System Design
    [TestingPlan.xlsx]
2013-11-25 Filled in some Testing Plan
    [TestingPlan.xlsx]
2013-11-27 Add pdf file of schematic
2013-11-27 Updated Testing Plan
    Missing data where lkfjslthe lies.
    [TestingPlan.xlsx]
2013-11-27 Added RF Tests. Still need to finish one.
    [TestingPlan.xlsx]
2013-11-27 update A lot of stuff
    [TestingPlan.xlsx]
2013-12-03 add schematic to powerpoint
2013-12-03 add border to schematic on powerpoint
2013-12-03 Interaction model on powerpoint.
2013-12-04 Powerpoint - add slides
    Implementation Power schematic, modules schematic, PCB,
    Verification slide
2013-12-07 turn on 4 leds
2013-12-07 added in timer
2013-12-11 add code for demo board
    add code for demo board (untested)
